ERZehr/SeniorDesign/WROVER_Code/README.md

# WROVER_Code
Libraries and functions for WROVER-based code, including BT, DSP, and UART

Example code found here: https://github.com/espressif/esp-idf/tree/master/examples/bluetooth/bluedroid/classic_bt/a2dp_sink
and here: https://github.com/espressif/esp-idf/blob/master/examples/peripherals/uart/uart_echo/main/uart_echo_example_main.c
