ERZehr/SeniorDesign/WROOM_Code/README.md

# WROOM_Code
Libraries and functions for WROOM-based code, including BLE, LED Matrix Driving, and Light Sensor Reading

Example code found here: https://github.com/mrfaptastic/ESP32-HUB75-MatrixPanel-DMA?tab=readme-ov-file \
and here: https://github.com/nkolban/ESP32_BLE_Arduino/tree/master/src
