ERZehr/SeniorDesign/WROOM_Code/WROOM_Code_Final/README.md

# _WROOM_Code_Final_

## Code Usage
Designed for ESP32 chips, specifically tested on the ESP32-WROOM-based DOIT DevKit v1. Library builds in Windows 10/11 VSCode using 
the ESP-IDF extension. Listed below are the requirements for a good build.

## Build Instructions
Download VSCode, and follow this tutorial to install the ESP-IDF extension: 
https://github.com/espressif/vscode-esp-idf-extension/blob/HEAD/docs/tutorial/install.md 

NOTE: It is important to install system files in a directory with the shortest path length possible (e.g., `C:\Users\{USERNAME}\esp`) to avoid potential build and flash issues.

After this is completed, follow these steps:
- Click on the ESP-IDF button on the left pane to see the Espressif Command List.
- Set the Espressif target as esp32 > ESP32 chip (via USB-Bridge).
- Ensure that the serial port matches the COM port on the machine.
- Build the project using the Espressif Build Command

## Flashing Instructions
After building the project, select the Espressif Flash Command (or Espressif Build, Flash, and Monitor command). If this is the first time
flashing with this library, a prompt will appear asking which interface to flash with: select UART.

## Interface Instructions
Flash, power, and reset the chip, using a serial monitor or signal debugger on TX0/RX0 to see incoming messages. On an Android-based smartphone, download the Artisyn app. Start a scan, ensure the app finds the Artisyn device, and connect to it. Use the sliders and buttons within the app to send the desired:
- Q-factor
- Center Frequency
- Band Number
- Theme
- Active (Spectrum Analyzer) / Idle (Graphics) Mode
