ERZehr/SeniorDesign/MISC/FinalPresSBD.png

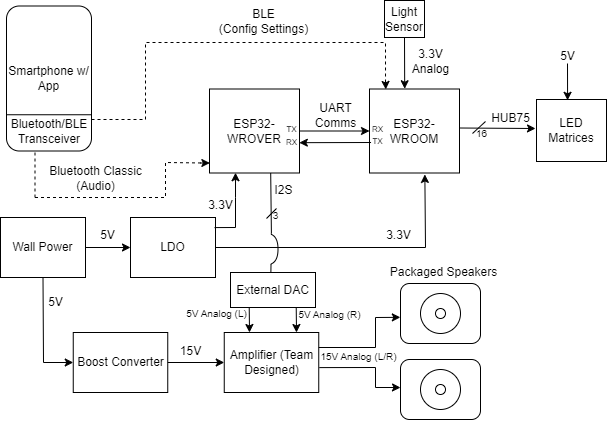
MISC/FinalPresSBD.png
