ERZehr/SeniorDesign/MISC/FunctionalSpecSBD.png

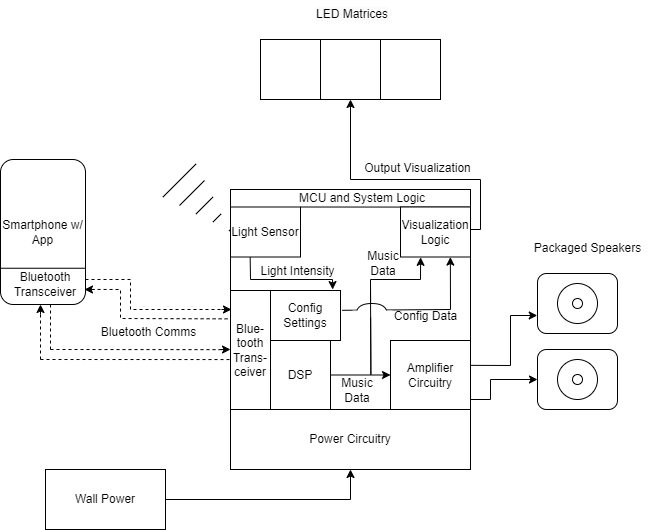
MISC/FunctionalSpecSBD.png
