ERZehr/SeniorDesign/MISC/MatrixDrawing.PNG

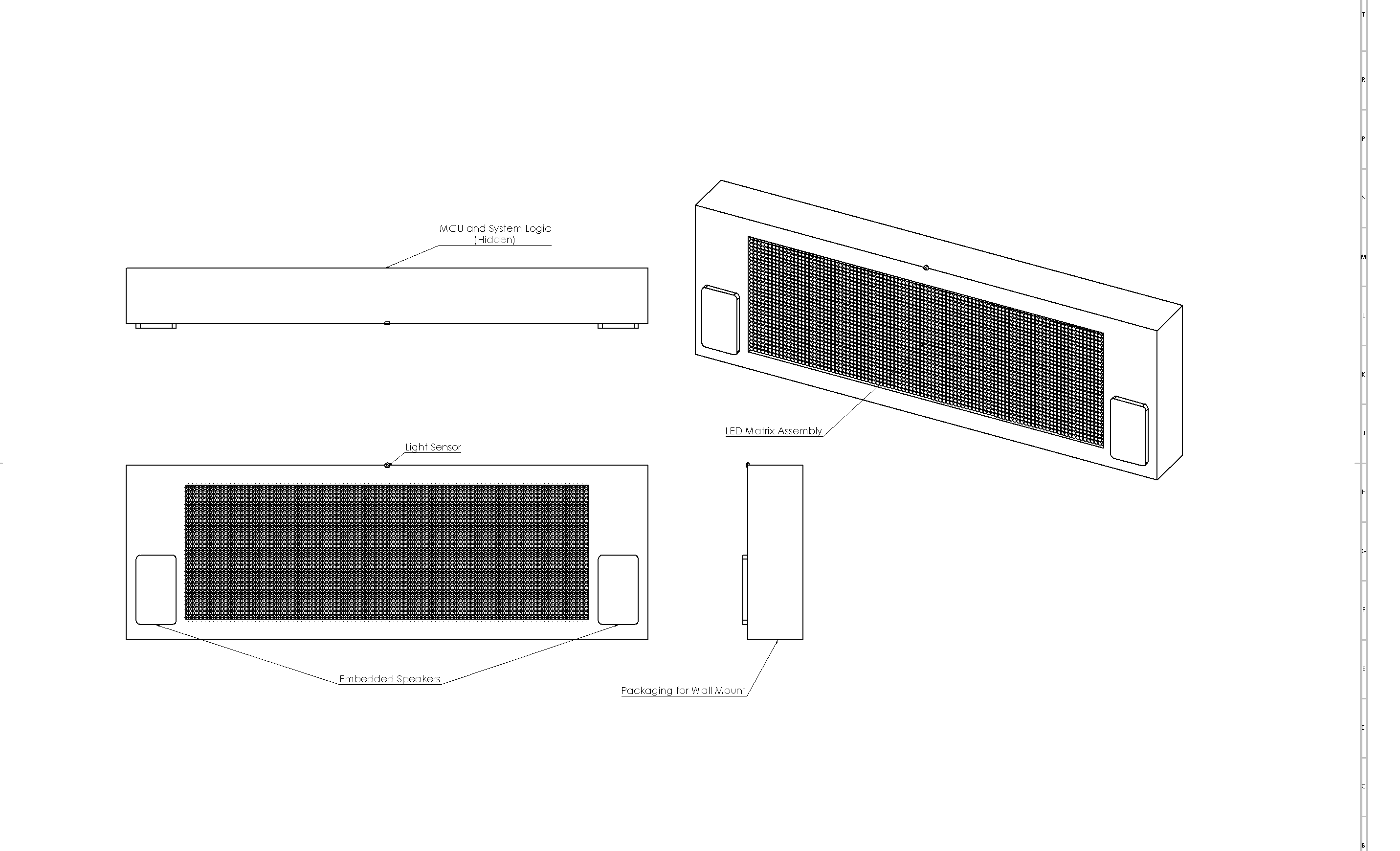
MISC/MatrixDrawing.PNG
