ERZehr/SeniorDesign/PCB/Artysin_Pretty_Components/README.md

# SeniorDesign
For any external libraries we might need.
