ERZehr/SeniorDesign/MISC/Matrix.SLDPRT

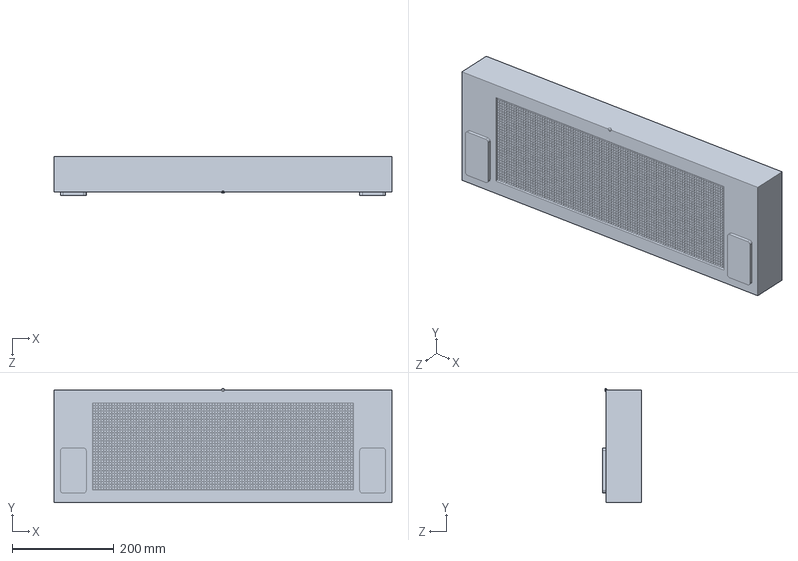
[picture p4: CAD file, 2024-01-19]
MISC/Matrix.SLDPRT
664.7 x 224.9 x 76.2 mm
