ERZehr/SeniorDesign/PCB/Light_Sensor/Light_Sensor.kicad_pcb

## KiCad design PCB/Light_Sensor/Light_Sensor.kicad_pcb (2024-03-06)

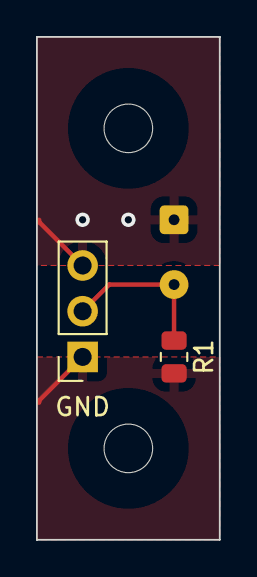
[picture p5: board Light_Sensor.kicad_pcb from above]

Board: 2 copper layers, 10.2 x 27.9 mm, 5 parts (0 on the bottom side), 3 nets.

Parts:
D1: D_Photo; SolderWire-0.1sqmm_1x02_P3.6mm_D0.4mm_OD1mm
GND: Conn_01x03; PinSocket_1x03_P2.54mm_Vertical
H1, H2: MountingHole; MountingHole_2.7mm
R1: 10k; R_0805_2012Metric

Connections:
3.3V: D1.1 (K), GND.3
GND: GND.1, R1.2
unnamed: D1.2 (A), GND.2, R1.1
