ERZehr/SeniorDesign/PCB/Main_PCB/PCB_Main_Final.kicad_pcb

## KiCad design PCB/Main_PCB/PCB_Main_Final.kicad_pcb (2024-03-06)

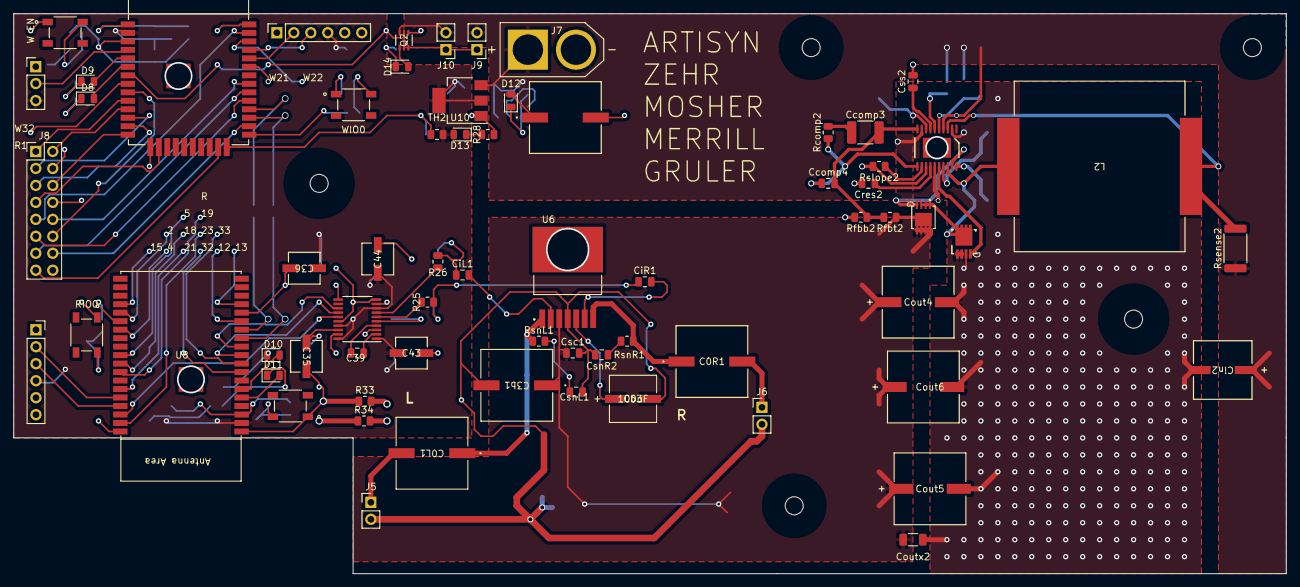
[picture p6: board PCB_Main_Final.kicad_pcb from above]

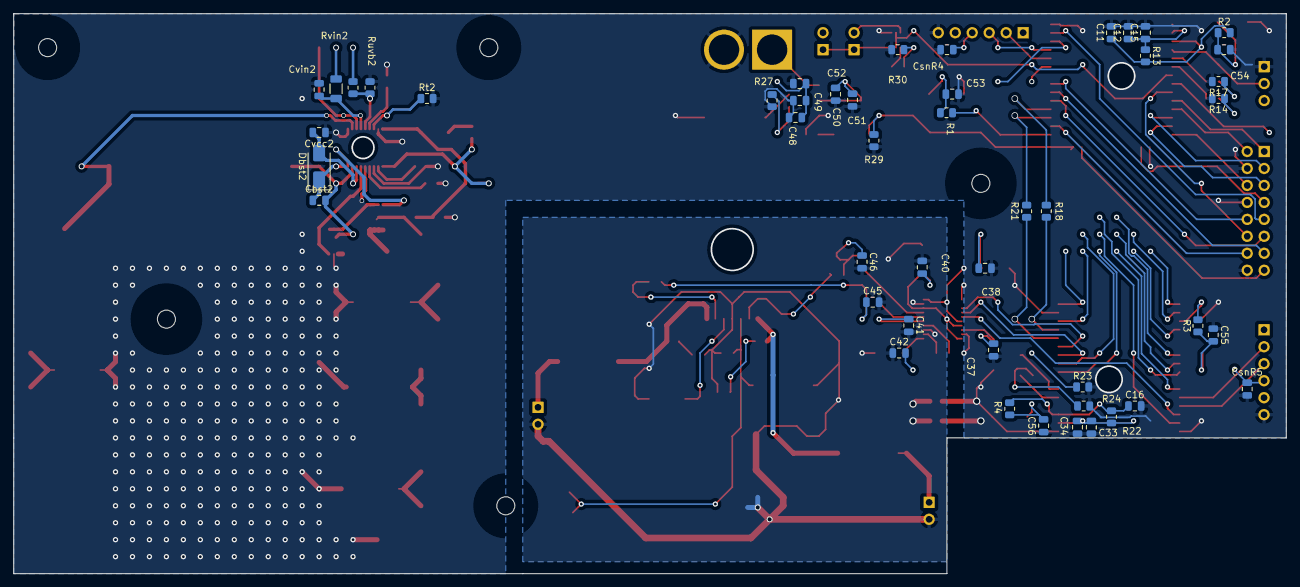
[picture p7: board PCB_Main_Final.kicad_pcb from below]

Board: 2 copper layers, 190.5 x 83.8 mm, 119 parts (47 on the bottom side), 85 nets.

Parts:
Boot2ROVER2, Boot2WROOM2: PinSocket_1x06_P2.54mm_Vertical
C0L1, C0R1, C3b1, C47: 1000uF; Audio_1000uF
C11, C15, C16, C34, C48, C49, C51, C53, C54, C55, C56: .1uF; C_0805_2012Metric
C12, C33: 22uF; C_0805_2012Metric
C35, C36, C43, C44: 10uF; EX_DAC_ELEC_CAPS_10uF
C37, C38, C40, C42: 0.1uF; C_0805_2012Metric
C39, C41: 2.2uF; C_0805_2012Metric
C45, C46: 2.2nF; C_0805_2012Metric
C50, C52: 10uF; C_0805_2012Metric
Cb3: 100uF; Audio_100uF
Cbst2: 470.0 nF; C_0805_2012Metric
Ccomp3: 18.0 nF; C_1812_4532Metric
Ccomp4: 1.0 nF; C_0805_2012Metric
CiL1: .1uF; C_0805_2012Metric
CiR1: .1uF; C_0805_2012Metric
Cin2: 270uF; PCAP_SVP_E7_PAN
Cout4, Cout5, Cout6: 560.0 uF; PCAP_SVP_F12_PAN
Coutx2: 47.0 uF; C_1206_3216Metric
Cres2: 470.0 nF; C_0805_2012Metric
Csc1: .1uF; C_0805_2012Metric
CsnL1: .1uF; C_0805_2012Metric
CsnR2, CsnR4, CsnR5: .1uF; C_0805_2012Metric
Css2: 33.0 nF; C_0805_2012Metric
Cvcc2: 10.0 uF; C_0805_2012Metric
Cvin2: 470.0 nF; C_0805_2012Metric
D8, D9, D10, D11: LED; LED_0805_2012Metric
D12, D13, D14: RED LED; LED_0805_2012Metric
Dbst2: D_Schottky; D_SMA
H6, H7, H8, H9, H10: MountingHole; MountingHole_2.7mm
J5: To_Speaker_L; PinHeader_1x02_P2.54mm_Vertical
J6: To_Speaker_R; PinHeader_1x02_P2.54mm_Vertical
J7: XT60-M; AMASS_XT60-M
J8: HUB75; PinHeader_2x08_P2.54mm_Vertical
J9, J10: fan connector; PinHeader_1x02_P2.54mm_Vertical
L2: 3.3 µH; IND_R3-R_EAT
LightSensorConnector2: Conn_01x03_Pin; PinHeader_1x03_P2.54mm_Vertical
M3: CSD17581Q3; CSD17309Q3
M4: CSD17581Q3A
Q2: Fan_NMOS; Fan_MOSFET
R1, R2, R3, R4: 100; R_0805_2012Metric
R13, R22, R29: 10k; R_0805_2012Metric
R14, R17, R23, R24, R28, R30: 1k; R_0805_2012Metric
R18, R21, R33, R34: 0; R_0805_2012Metric
R25, R26: 470; R_0805_2012Metric
R27: 2k; R_0805_2012Metric
RIO0: SW_Push; Boot_Switches
Rcomp2: 23.7k; R_0805_2012Metric
Rfbb2: 3.65k; R_0805_2012Metric
Rfbt2: 39.0k; R_0805_2012Metric
Rsense2: 1.5m; R_2512_6332Metric
Rslope2: 150.0k; R_0805_2012Metric
RsnL1: 2.7; R_0805_2012Metric
RsnR1: 2.7; R_0805_2012Metric
Rt2: 41.2k; R_0805_2012Metric
Ruvb2: 19.1k; R_0805_2012Metric
Ruvt2: 49.9k; R_0805_2012Metric
Rvin2: 3.01; R_1206_3216Metric
SW8: SW_Push; Boot_Switches
TH2: Thermistor; R_0805_2012Metric
U6: LM4752TS; LM4752
U7: ESP32-WROOM-E; ESP32-WROOM-32E
U8: ESP32-WROVER-E
U9: PCM5102A; TSSOP-20_4.4x6.5mm_P0.65mm
U10: AMS1117-3.3; SOT-223-3_TabPin2
U11: LM5122MH/NOPB; LM512220A_L
W EN: SW_Push; Boot_Switches
WIO0: SW_Push; Boot_Switches

Connections:
3.3V: Boot2ROVER2.4 (VCC), Boot2WROOM2.4 (VCC), C12.1, C15.1, C33.1, C34.1, C36.1, C38.2, C40.2, C42.2, C43.1, C44.1, C51.1, C52.1, CsnR4.1, CsnR5.1, D13.2 (A), LightSensorConnector2.3, R13.1, R22.1, TH2.1, U7.2 (3V3), U8.2 (3V3), U9.1 (CPVDD), U9.8 (AVDD), U9.17 (XSMT), U9.20 (DVDD), U10.2 (VO)
5V: C47.1, C48.1, C49.1, C50.1, Cin2.1, D12.2 (A), J7.P (POS), J9.2, J10.2, Q2.6 (D1), Rsense2.1, Ruvt2.1, Rvin2.1, U10.3 (VI), U11.4 (CSP)
14V: C3b1.1, Cout4.1, Cout5.1, Cout6.1, Coutx2.1, Csc1.1, M4.5 (DRAIN), M4.6 (DRAIN), M4.7 (DRAIN), M4.8 (DRAIN), M4.9 (DRAIN), Rfbt2.1, U6.3 (Vcc)
AGND: C3b1.2, C40.1, C41.2, C42.1, C43.2, C44.2, C45.2, C46.2, Cb3.2, Csc1.2, CsnL1.2, CsnR2.2, J5.2, J6.2, R33.2, R34.2, U6.4 (GND), U9.3 (CPGND), U9.9 (AGND)
A_PIN: J8.9, U7.37 (GPIO23)
B1_PIN: J8.3, U7.12 (ADC2_CH7/GPIO27)
B2_PIN: J8.7, U7.16 (MTCK/GPIO13/ADC2_CH4)
B_PIN: J8.10, U7.31 (GPIO19)
CLK_PIN: J8.13, U7.30 (GPIO18)
C_PIN: J8.11, U7.29 (GPIO5)
D_PIN: J8.12, U7.9 (32K_XN/GPIO33/ADC1_CH5)
EN_ROVER: C16.1, R4.2, R22.2, U8.3 (EN/CHIP_PU)
EN_WROOM: C11.1, R2.2, R13.2, U7.3 (EN/CHIP_PU)
G1_PIN: J8.2, U7.11 (DAC_2/ADC2_CH9/GPIO26)
G2_PIN: J8.6, U7.14 (MTDI/GPIO12/ADC2_CH5)
GND: Boot2ROVER2.6 (GND), Boot2WROOM2.6 (GND), C11.2, C12.2, C15.2, C16.2, C33.2, C34.2, C35.2, C36.2, C37.2, C38.1, C47.2, C48.2, C49.2, C50.2, C51.2, C52.2, C53.1, C54.1, C55.1, C56.1, Cin2.2, Cout4.2, Cout5.2, Cout6.2, Coutx2.2, Cres2.2, CsnR4.2, CsnR5.2, Css2.2, Cvcc2.1, Cvin2.2, J7.N (NEG), J8.4, J8.8, J8.16, LightSensorConnector2.1, M3.1 (S1), M3.2 (S2), M3.3 (S3), Q2.4 (S2), R14.2, R17.2, R23.2, R24.2, R27.2, R28.2, R29.2, R30.2, R33.1, R34.1, RIO0.1, Rfbb2.2, Rslope2.2, Rt2.2, Ruvb2.2, SW8.1, U7.1 (GND), U7.15 (GND), U7.38 (GND), U7.39 (GND_THERMAL), U8.1 (GND), U8.15 (GND), U8.38 (GND), U8.39 (GND_THERMAL), U9.10 (DEMP), U9.11 (FLT), U9.16 (FMT), U9.19 (DGND), U10.1 (GND), U11.2 (OPT), U11.9 (AGND), U11.13 (MODE), U11.15 (PGND), W EN.1, WIO0.1
I2S-BCK: U8.11 (DAC_2/ADC2_CH9/GPIO26), U9.13 (BCK)
I2S-WS: U8.36 (GPIO22), U9.15 (LRCK)
I2S_DATA: U8.10 (DAC_1/ADC2_CH8/GPIO25), U9.14 (DIN)
IO0_ROVER: R3.2, U8.25 (GPIO0/BOOT/ADC2_CH1)
IO0_WROOM: R1.2, U7.25 (GPIO0/BOOT/ADC2_CH1)
Left_Audio: C46.1, CiL1.1, R26.2
Light_Reading: LightSensorConnector2.2, U7.4 (SENSOR_VP/GPIO36/ADC1_CH0)
unnamed: C53.2, R1.1, WIO0.2
unnamed: C54.2, R2.1, W EN.2
unnamed: C55.2, R3.1, RIO0.2
unnamed: C56.2, R4.1, SW8.2
unnamed: Ccomp3.1, Rcomp2.2
unnamed: CsnL1.1, RsnL1.2
unnamed: CsnR2.1, RsnR1.2
unnamed: D8.2 (A), U7.6 (GPIO34/ADC1_CH6)
unnamed: D8.1 (K), R14.1
unnamed: D9.2 (A), U7.5 (SENSOR_VN/GPIO39/ADC1_CH3)
unnamed: D9.1 (K), R17.1
unnamed: D10.2 (A), U8.6 (GPIO34/ADC1_CH6)
unnamed: D10.1 (K), R23.1
unnamed: D11.2 (A), U8.5 (SENSOR_VN/GPIO39/ADC1_CH3)
unnamed: D11.1 (K), R24.1
unnamed: D12.1 (K), R27.1
unnamed: D13.1 (K), R28.1
unnamed: D14.2 (A), Q2.1 (S1)
unnamed: D14.1 (K), R30.1
unnamed: Cvcc2.2, Dbst2.2 (A), U11.17 (VCC)
unnamed: Cbst2.1, Dbst2.1 (K), U11.20 (BST)
unnamed: J9.1, J10.1, Q2.3 (D2)
unnamed: C0L1.2, J5.1
unnamed: C0R1.2, J6.1
unnamed: Cbst2.2, L2.2, M3.5 (D1), M3.6 (D2), M3.7 (D3), M3.8 (D4), M3.9 (Back), M4.1 (SOURCE), M4.2 (SOURCE), M4.3 (SOURCE), U11.18 (SW)
unnamed: M3.4 (G), U11.16 (LO)
unnamed: M4.4 (GATE), U11.19 (HO)
unnamed: C39.2, U9.4 (CAPM)
unnamed: C39.1, U9.2 (CAPP)
unnamed: C35.1, C37.1, U9.18 (LDOO)
unnamed: R25.1, U9.6 (OUTL)
unnamed: R26.1, U9.7 (OUTR)
unnamed: C41.1, U9.5 (VNEG)
unnamed: Ccomp4.1, Rcomp2.1, U11.11 (COMP)
unnamed: L2.1, Rsense2.2, U11.3 (CSN)
unnamed: Ccomp3.2, Ccomp4.2, Rfbb2.1, Rfbt2.2, U11.10 (FB)
unnamed: Cres2.1, U11.14 (RES)
unnamed: Rslope2.1, U11.12 (SLOPE)
unnamed: Css2.1, U11.7 (SS)
unnamed: Rt2.1, U11.8 (SYNCIN_RT)
unnamed: Ruvb2.1, Ruvt2.2, U11.6 (UVLO)
unnamed: Cvin2.1, Rvin2.2, U11.5 (VIN)
unnamed: Cb3.1, U6.5 (Bias)
unnamed: CiR1.2, U6.6 (In_A)
unnamed: CiL1.2, U6.2 (In_B)
unnamed: C0R1.1, RsnR1.1, U6.7 (Out_A)
unnamed: C0L1.1, RsnL1.1, U6.1 (Out_B)
OE_PIN: J8.15, U7.23 (MTDO/GPIO15/ADC2_CH3)
R1_PIN: J8.1, U7.10 (DAC_1/ADC2_CH8/GPIO25)
R2_PIN: J8.5, U7.13 (MTMS/GPIO14/ADC2_CH6)
ROVER_TALK_RX: R18.2, U8.13 (MTMS/GPIO14/ADC2_CH6)
ROVER_TALK_TX: R21.2, U8.12 (ADC2_CH7/GPIO27)
RXD0_ROVER: Boot2ROVER2.2 (RX), U8.34 (U0RXD/GPIO3)
RXD0_WROOM: Boot2WROOM2.2 (RX), U7.34 (U0RXD/GPIO3)
Right_Audio: C45.1, CiR1.1, R25.2
STB: J8.14, U7.26 (ADC2_CH0/GPIO4)
TXD0_ROVER: Boot2ROVER2.3 (TX), U8.35 (U0TXD/GPIO1)
TXD0_WROOM: Boot2WROOM2.3 (TX), U7.35 (U0TXD/GPIO1)
Therm_Reading: R29.1, TH2.2, U7.24 (ADC2_CH2/GPIO2)
WROOM_TALK_RX: R21.1, U7.27 (GPIO16)
WROOM_TALK_TX: R18.1, U7.28 (GPIO17)
WROOM_TO_FANS: Q2.2 (G1), Q2.5 (G2), U7.7 (GPIO35/ADC1_CH7)
