ERZehr/SeniorDesign/PCBs/PCB_Main_Final/MISC.kicad_sch

## KiCad design PCBs/PCB_Main_Final/MISC.kicad_sch (2024-03-04)

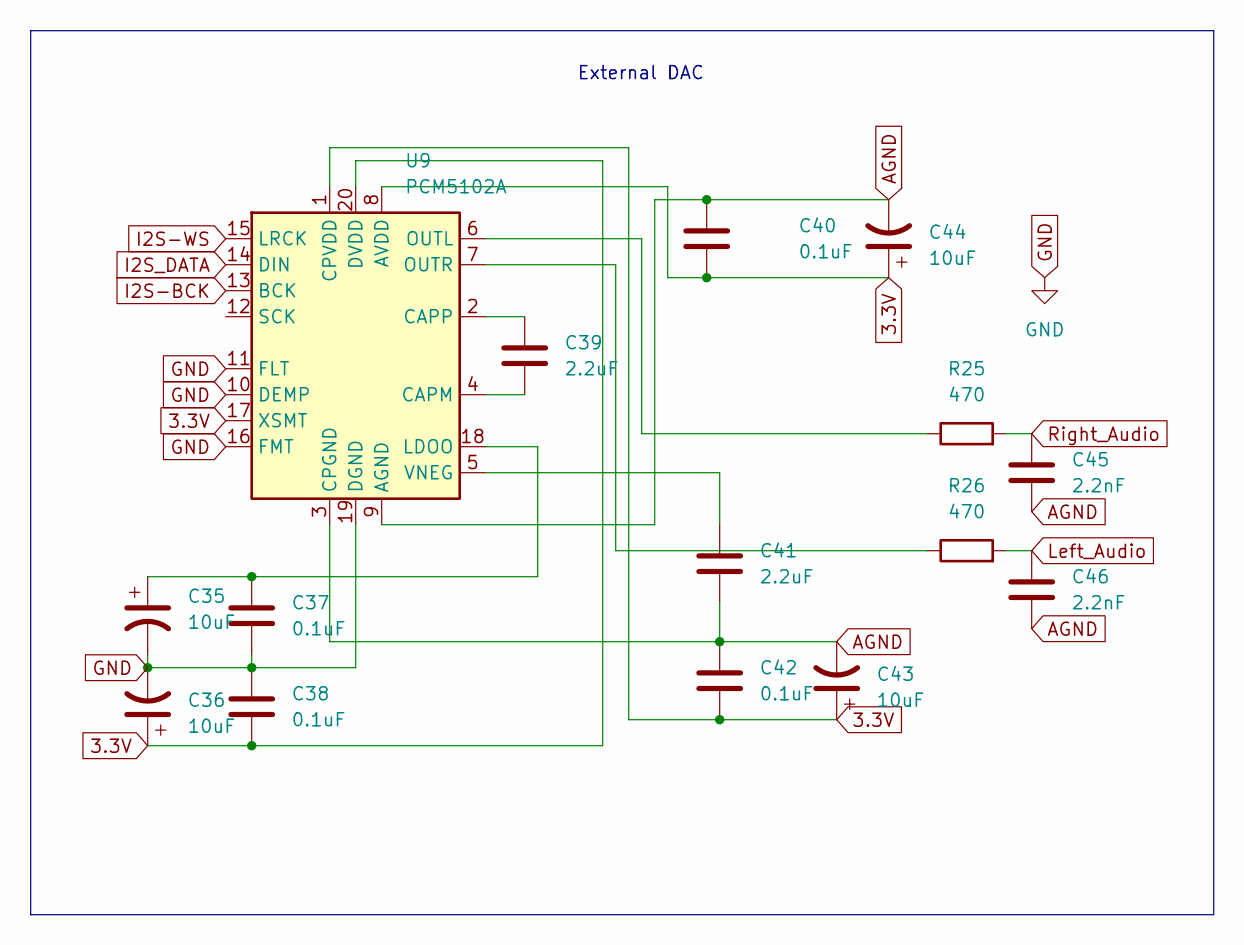
[picture p8: schematic MISC.kicad_sch]

Parts:
C35, C36, C43, C44: 10uF; EX_DAC_ELEC_CAPS_10uF
C37, C38, C40, C42: 0.1uF; C_0805_2012Metric
C39, C41: 2.2uF; C_0805_2012Metric
C45, C46: 2.2nF; C_0805_2012Metric
R25, R26: 470; R_0805_2012Metric
U9: PCM5102A; TSSOP-20_4.4x6.5mm_P0.65mm

Connections:
3.3V: C36.1, C38.2, C40.2, C42.2, C43.1, C44.1, U9.1 (CPVDD), U9.8 (AVDD), U9.17 (XSMT), U9.20 (DVDD)
AGND: C40.1, C41.2, C42.1, C43.2, C44.2, C45.2, C46.2, U9.3 (CPGND), U9.9 (AGND)
GND: C35.2, C36.2, C37.2, C38.1, U9.10 (DEMP), U9.11 (FLT), U9.16 (FMT), U9.19 (DGND)
I2S-BCK: U9.13 (BCK)
I2S-WS: U9.15 (LRCK)
I2S_DATA: U9.14 (DIN)
Left_Audio: C46.1, R26.2
unnamed: C35.1, C37.1, U9.18 (LDOO)
unnamed: C39.1, U9.2 (CAPP)
unnamed: C39.2, U9.4 (CAPM)
unnamed: C41.1, U9.5 (VNEG)
unnamed: R25.1, U9.6 (OUTL)
unnamed: R26.1, U9.7 (OUTR)
Right_Audio: C45.1, R25.2

Notes on the sheet:
External DAC
