ERZehr/SeniorDesign/WROOM_Code/WROOM_Code_Final/main/Startup.h

/*****************************************
 * ECE 477 Team 8 "Artisyn" Credits:
 * 
 * Bailey Mosher:
 *    * Custom startup logo scheme, background animation
 * 
*****************************************/
#ifndef Startup_H
#define Startup_H
#include <inttypes.h>

// The ARTISYN logo in all its glory
// Note: Since the matrix is set up like:
/*
| 95 | ... |  1  |  0 |
                     | 31 |
                      ...
                      ...
                     | 1 |  
                     | 0 |

*/
// The matrix is written to match the layout - but still needs to be inverted because C matrices go [row][col]
// and the matrix wants to be drawn [col][row]
static uint8_t artisyn_logo[32][96] = {
{0,0,0,0,0,0,0,0,0,0,0,0,0,0,0,0,0,0,0,0,0,0,0,0,0,0,0,0,0,0,0,0,0,0,0,0,0,0,0,0,0,0,0,0,0,0,0,0,0,0,0,0,0,0,0,0,0,0,0,0,0,0,0,0,0,0,0,0,0,0,0,0,0,0,0,0,0,0,0,0,0,0,0,0,0,0,0,0,0,0,0,0,0,0,0,0},
{0,0,0,0,0,0,0,0,0,0,0,0,0,0,0,0,0,0,0,0,0,0,0,0,0,0,0,0,0,0,0,0,0,0,0,0,0,0,0,0,0,0,0,0,0,0,0,0,0,0,0,0,0,0,0,0,0,0,0,0,0,0,0,0,0,0,0,0,0,0,0,0,0,0,0,0,0,0,0,0,0,0,0,0,0,0,0,0,0,0,0,0,0,0,0,0},
{0,0,0,0,0,0,0,0,0,0,0,0,0,0,0,0,0,0,0,0,0,0,0,0,0,0,0,0,0,0,0,0,0,0,0,0,0,0,0,0,0,0,0,0,0,0,0,0,0,0,0,0,0,0,0,0,0,0,0,0,0,0,0,0,0,0,0,0,0,0,0,0,0,0,0,0,0,0,0,0,0,0,0,0,0,0,0,0,0,0,0,0,0,0,0,0},
{0,0,0,0,0,0,0,0,0,0,0,0,0,0,0,0,0,0,0,0,0,0,0,0,0,0,0,0,0,0,0,0,0,0,0,0,0,0,0,0,0,0,0,0,0,0,0,0,0,0,0,0,0,0,0,0,0,0,0,0,0,0,0,0,0,0,0,0,0,0,0,0,0,0,0,0,0,0,0,0,0,0,0,0,0,0,0,0,0,0,0,0,0,0,0,0},
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
            cycles = 0;
        }

        EVERY_N_MILLIS(250) {
            blur_factor++;
        }
        // Don't let it get too blurry - just in case
        if(blur_factor >= 100) {
            blur_factor = 100;
        }

        effects.ShowFrame();

        return 30;
    }
};

#endif
