ERZehr/SeniorDesign/WROVER_Code/WROVER_Code_Final/main/bt_dsp.h

#include <stdint.h>
#include <stdbool.h>
#include <stdlib.h>
#include <string.h>
#include <inttypes.h>
#include "esp_log.h"

#define DSP_TAG "DSP"
#define BAND_MAX 8
#define L_R_BYTE_NUM 4
#define DSP_OK true
#define COEFF_SAMPLE_MAX 20

extern float get_dsp_coeff(int idx);

/* 
    DSP Capabilities inspired by these past projects:

        https://hackaday.io/project/166122-esp32-as-bt-receiver-with-dsp-capabilities
        https://github.com/YetAnotherElectronicsChannel/ESP32_Bluetooth_DSP_Speaker/tree/master
*/

/**
 * @brief Time-domain representation of an IIR filter with coefficients for each of 12 bands
 *
 * @param [in] media       byte array of media data
 * @param [in] len         length of media array (typ. 4096)
 * @param [in] outBuf      byte array of output media data
 * @param [in] band_num    number of bands to display (does not change actual DSP on audio)
 * 
 * @return  true if malloc'd and filtered correctly - false otherwise
 */
bool bt_media_biquad_bilinear_filter(uint8_t *media, uint32_t len, uint8_t* outBuf, uint8_t band_num);

/**
 * @brief Grabs multiplier coefficients for each frequency band
 *
 * @param [in] idx       which band to grab the coefficient of
 * 
 * @return  coefficient of requested bande
 */
int get_coeff(int idx);
