ERZehr/SeniorDesign/(commit log)

2024-01-19 Add files via upload
    Drawings and system overview
    [Matrix.SLDPRT]
2024-01-21 Added voltage regulation and light sensor circuit diagrams
2024-02-07 editing power module
2024-02-13 Create esp32
2024-02-13 added PCBs
    [Boost_Audio.kicad_pcb, Boost_Audio.kicad_sch, Light_Sensor.kicad_pcb, Light_Sensor.kicad_sch, PCB_Main.kicad_pcb, PCB_Main.kicad_sch]
2024-02-14 new decoupling cap
    [Boost_Audio.kicad_sch]
2024-02-14 updated PCB main
    [PCB_Main.kicad_sch]
2024-02-15 latest PCBs
    [Boost_Audio.csv, Boost_Audio.kicad_sch, Light_Sensor.kicad_pcb, Light_Sensor.kicad_sch, PCB_Main.kicad_sch]
2024-02-16 PCB combination
    [PCB_Main.kicad_sch]
2024-02-16 PCB, LED pins and light sensor pins added
    [PCB_Main.kicad_sch]
2024-02-16 merged into one PCB
    [PCB_Main.kicad_pcb, PCB_Main.kicad_sch]
2024-02-19 UART pins
    [PCB_Main.kicad_sch]
2024-02-19 Corrected UART receive and transmit pins
    [PCB_Main.kicad_sch]
2024-02-20 finished schematic
    [PCB_Main.kicad_sch]
2024-02-21 finished Schematic spread PCB compnets for footprint compare
    [PCB_Main.kicad_pcb, PCB_Main.kicad_sch]
2024-02-21 started PCB Layout
    [PCB_Main.kicad_pcb, PCB_Main.kicad_sch]
2024-02-21 PCB reset traces
    [PCB_Main.kicad_pcb, PCB_Main.kicad_sch]
2024-02-21 fixed footprints
    [PCB_Main.kicad_sch]
2024-02-26 pcb almost done
    [PCB_Main.kicad_pcb, PCB_Main.kicad_sch]
2024-02-27 updates to PCB
    [PCB_Main.kicad_pcb, PCB_Main.kicad_sch]
2024-02-28 PCB no errors, added PCB sandbox
    [PCB_Main.kicad_pcb, PCB_Main.kicad_sch, PCB_Main_Sandbox.kicad_pcb, PCB_Main_Sandbox.kicad_sch]
2024-02-28 Finished PCB sandbox design and added gbr and drl files
    [PCB_Main_Sandbox-B_Cu.gbr, PCB_Main_Sandbox-B_Mask.gbr, PCB_Main_Sandbox-B_Paste.gbr, PCB_Main_Sandbox-B_Silkscreen.gbr, PCB_Main_Sandbox-Edge_Cuts.gbr, PCB_Main_Sandbox-F_Cu.gbr, PCB_Main_Sandbox-F_Mask.gbr, PCB_Main_Sandbox-F_Paste.gbr]
2024-02-28 fixed PCB layout and updated gbr and drl files
    [Light_Sensor-B_Cu.gbr, Light_Sensor-B_Mask.gbr, Light_Sensor-B_Paste.gbr, Light_Sensor-B_Silkscreen.gbr, Light_Sensor-Edge_Cuts.gbr, Light_Sensor-F_Cu.gbr, Light_Sensor-F_Mask.gbr, Light_Sensor-F_Paste.gbr]
2024-02-28 fixed trace
    [Light_Sensor-B_Cu.gbr, Light_Sensor-B_Mask.gbr, Light_Sensor-B_Paste.gbr, Light_Sensor-B_Silkscreen.gbr, Light_Sensor-Edge_Cuts.gbr, Light_Sensor-F_Cu.gbr, Light_Sensor-F_Mask.gbr, Light_Sensor-F_Paste.gbr]
2024-03-02 Arduino-Based - cut bloat and unnecessary patterns
2024-03-04 added final design files (not complete)
    [Boost_Audio.kicad_sch, Boot.kicad_sch, Microcontrollers.kicad_sch, PCB_Main_Final.kicad_pcb, PCB_Main_Final.kicad_sch, Power_and_Sensors.kicad_sch, untitled.kicad_sch]
2024-03-05 finished Main and Light Sensor PCBs
    [Boot.kicad_sch, Light_Sensor.kicad_pcb, Light_Sensor.kicad_sch, Microcontrollers.kicad_sch, PCB_Main_Final.kicad_pcb, Power_and_Sensors.kicad_sch]
2024-03-05 GRB and DRL added
    [Boost_Audio.kicad_sch, Boot.kicad_sch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]
2024-03-05 VSCode LED Matrix Code
    [gen4esp32_16MBapp.csv, gen4esp32_2MBapp_2MBota_12MBspiffs.csv, gen4esp32_4MBapp_4MBota_7MBspiffs.csv, gen4esp32_8MBapp_8MBota.csv, partitions-16MB-tinyuf2.csv, partitions-4MB-tinyuf2.csv, partitions-8MB-tinyuf2.csv, partitions-8MB.csv]
2024-03-06 New audio amplifier PCB
    [PCB_Main_Sandbox.kicad_pcb]
2024-03-06 fixed board outline and generated new GBR and DRL files
    [PCB_Main_Final.kicad_pcb]
2024-03-06 fixed vias and expanded boost converter
    [External_DAC.kicad_sch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]
2024-03-06 WDT Fixed - FlowField Fixed
    [PatternFlowField.h, Patterns.h, main.cpp]
2024-03-07 Bloat removal
    [app3M_fat9M_16MB.csv, app3M_fat9M_fact512k_16MB.csv, app3M_spiffs9M_fact512k_16MB.csv, bare_minimum_2MB.csv, default.csv, default_16MB.csv, default_8MB.csv, default_ffat.csv]
2024-03-20 WROOM_Code Initial Commit, build delete in LED_Matrix
2024-03-25 WROOM Build Fix, bad DSP code
    [bt_dsp.c, main.cpp]
2024-03-26 Analog read update - runs on PCB
2024-04-02 One-filter BT/DSP
2024-04-02 README changes, initial UART commit - doesn't work yet
    [Boid.h, Drawable.h, Effects.h, PatternFlowField.h, PatternSpiral.h, Patterns.h, main.cpp]
2024-04-04 BLE Advertising Fix, WROVER DSP testing
    [main.cpp]
2024-04-04 Initial UART - tested
2024-04-04 UART done for both WROOM and WROVER
2024-04-04 UART edited 30 HZ max, DSP in progress
2024-04-06 Band logic fixed - need accurate constants. DSP needs work
    [Equalizer.h, bt_app_all.c, bt_dsp.c]
2024-04-19 WROOM TX Pin Change
2024-04-20 Submodule fix?
    [gen4esp32_16MBapp.csv, gen4esp32_2MBapp_2MBota_12MBspiffs.csv, gen4esp32_4MBapp_4MBota_7MBspiffs.csv, gen4esp32_8MBapp_8MBota.csv, partitions-16MB-tinyuf2.csv, partitions-4MB-tinyuf2.csv, partitions-8MB-tinyuf2.csv, partitions-8MB.csv]
2024-04-22 removed fluff and deleted updated PCB directory
    [Boost_Audio.kicad_sch, Boot.kicad_sch, External_DAC.kicad_sch, Light_Sensor.kicad_pcb, Light_Sensor.kicad_sch, Microcontrollers.kicad_sch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]
2024-04-25 Updated Mobile App code to current
